DeathByLogic/shutterpod/hardware/Gerber/Shutter Pod Schematic.TXT

%
M48
M72
T01C0.0240
T02C0.0394
T03C0.0400
T04C0.0433
T05C0.0472
T06C0.0984
%
T01
X9431Y1556
X7141Y4171
X13061Y6821
X13931Y7681
X14556Y8306
X12101Y8981
X10101Y9301
X9621Y9301
X12101Y10021
X16901Y11541
X19436Y11966
X21306Y12681
X21221Y13541
X23861Y12741
X23141Y11141
X25061Y10661
X23941Y10421
X24661Y10261
X25541Y9701
X22901Y9301
X22671Y8706
X20901Y9061
X20681Y8021
X22821Y7541
X23301Y7621
X22821Y7061
X24341Y7461
X25711Y8021
X27861Y7141
X26581Y6341
X26261Y5941
X24741Y6421
X25781Y6741
X23541Y5941
X22421Y5941
X22021Y5541
X23941Y5301
X24421Y5301
X25221Y4501
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
