DeathByLogic/shutterpod/hardware/Shutter Pod Schematic.png

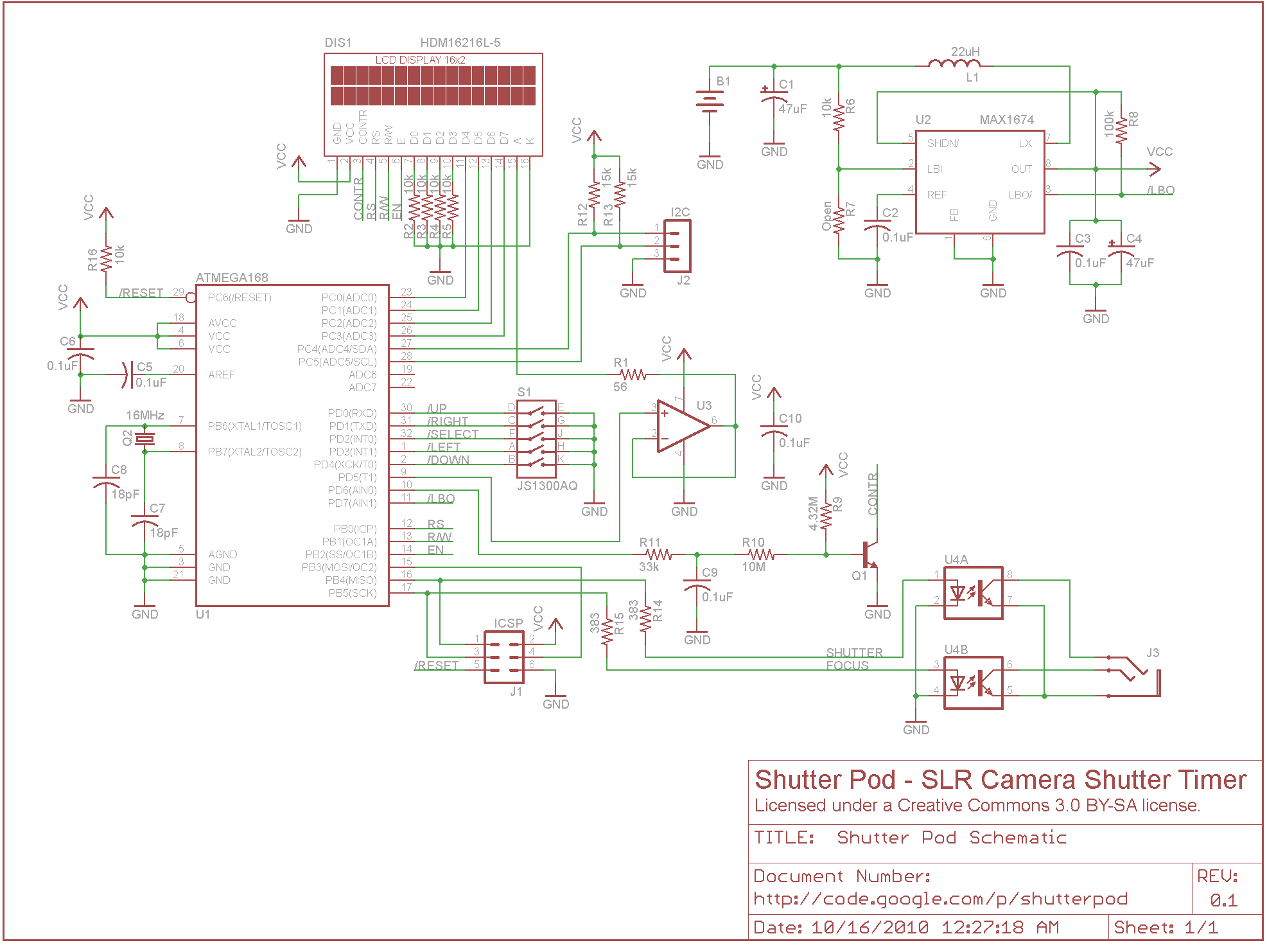
hardware/Shutter Pod Schematic.png
