DeathByLogic/shutterpod/case/Shutter Pod v1 Case.FCStd

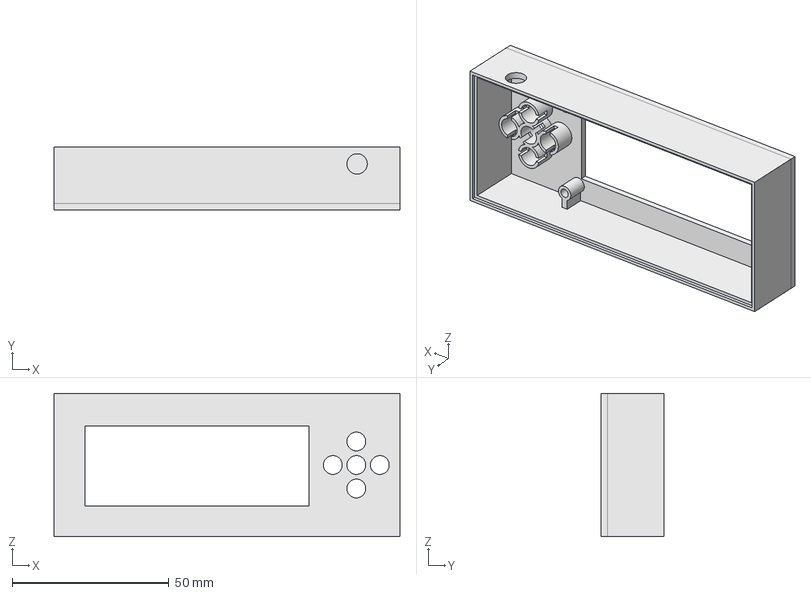
[picture p2: CAD file, 2014-07-27]
case/Shutter Pod v1 Case.FCStd
110.4 x 20.0 x 45.6 mm
