DeathByLogic/shutterpod/case/Button - Center.FCStd

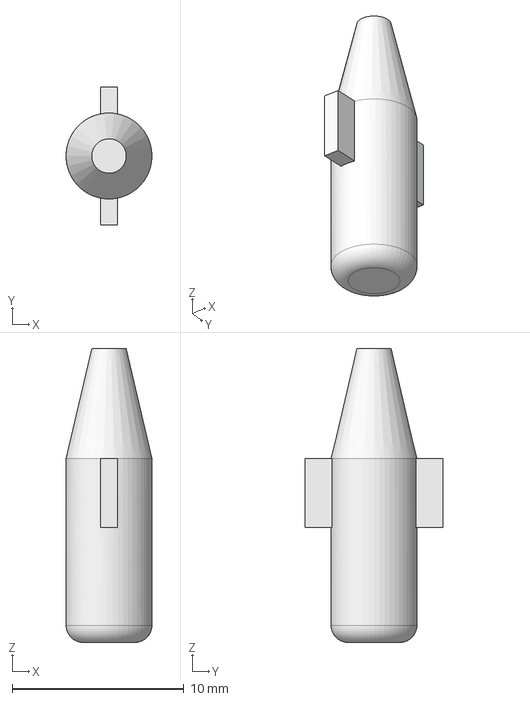
[picture p3: CAD file, 2014-07-27]
case/Button - Center.FCStd
5.00 x 8.00 x 17.1 mm
