DeathByLogic/shutterpod/case/Button - Angle.FCStd

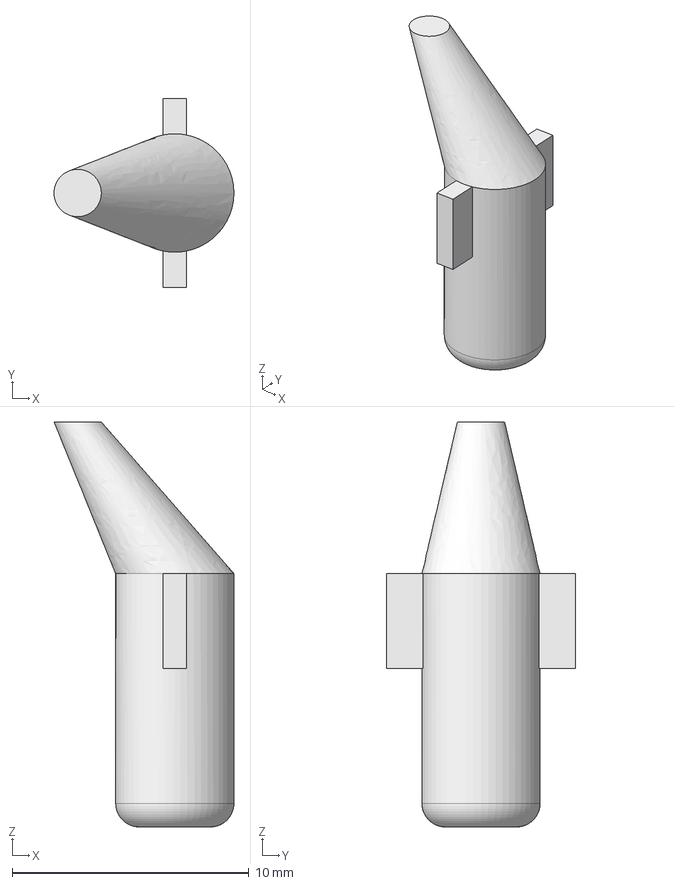
[picture p4: CAD file, 2014-07-27]
case/Button - Angle.FCStd
7.60 x 8.00 x 17.1 mm
