DeathByLogic/shutterpod/(list of files, cad)

Other CAD files:
case/Button - Angle.stl
case/Button - Center.stl
case/Shutter Pod v1 Case.stl
