DeathByLogic/shutterpod/hardware/Shutter Pod Schematic.brd

## EAGLE design hardware/Shutter Pod Schematic.brd (2014-08-19)

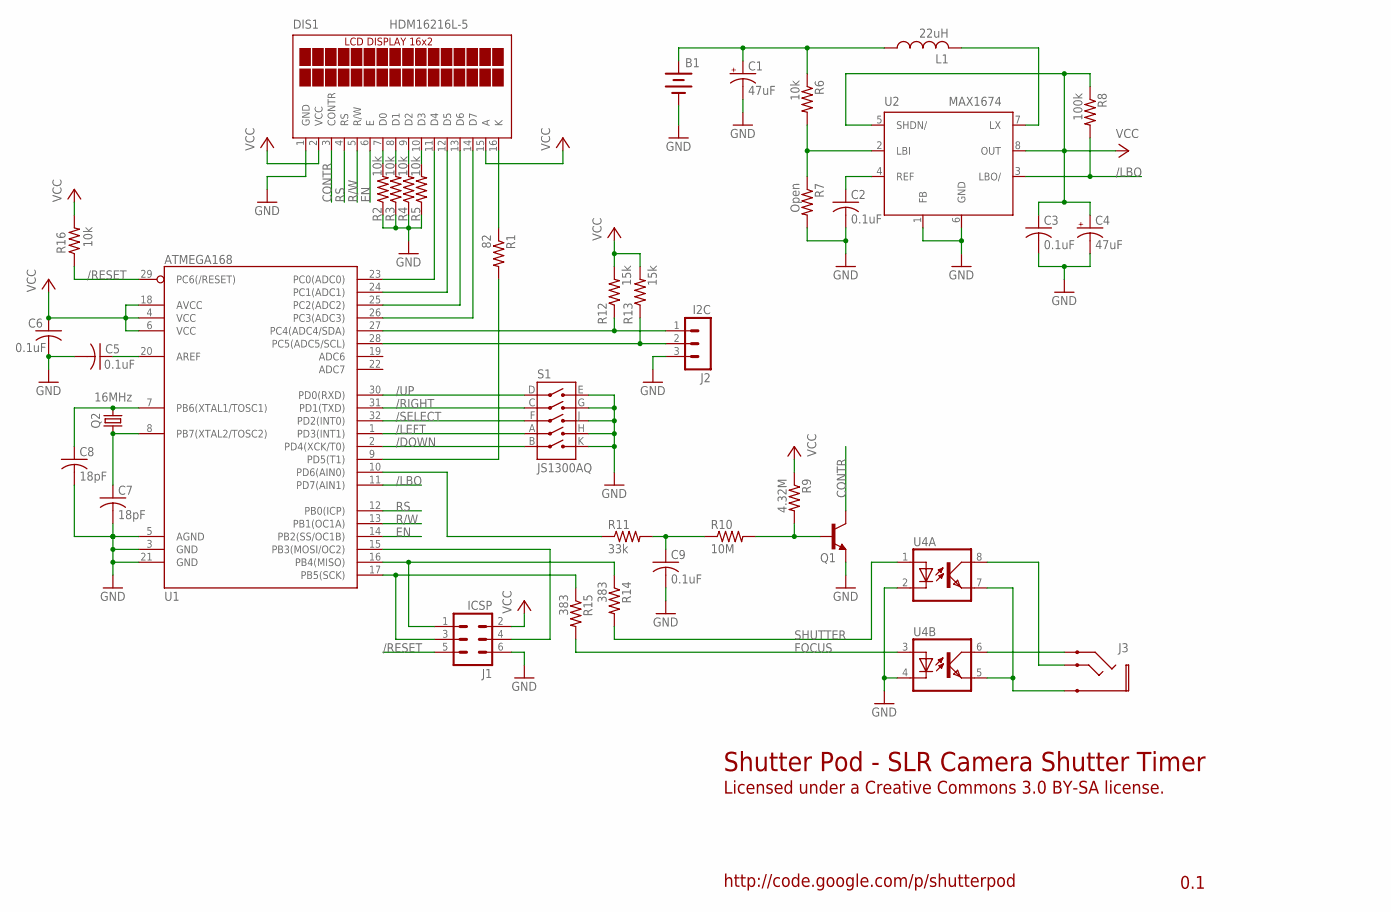
[picture p5: schematic Shutter Pod Schematic.sch]

Parts:
B1: BATTERY
C1, C4: 47uF; SMC_D
C2, C3, C5, C6, C9: 0.1uF; C0805
C7, C8: 18pF; C0805
DIS1: HDM16216L-5
J1: ICSP; MA03-2W
J2: I2C; MA03-1W
J3: 2.5MM_AUDIO; 161-2625-E
L1: 22uH; L2220P
Q1: BC817-25SMD; SOT23-BEC
Q2: 16MHz; HC49UP
R1: 82; R0805
R2, R3, R4, R5, R6, R16: 10k; R0805
R7: Open; R0805
R8: 100k; R0805
R9: 4.32M; R0805
R10: 10M; R0805
R11: 33k; R0805
R12, R13: 15k; R0805
R14, R15: 383; R0805
S1: JS1300AQ
U1: ATMEGA168; TQFP32-08
U2: MAX1674; UMAX8
U4: MOCD217M; SO08

Connections:
/DOWN: S1.B, U1.2 (PD4(XCK/T0))
/LBO: R8.2, U1.11 (PD7(AIN1)), U2.3 (LBO/)
/LEFT: S1.A, U1.1 (PD3(INT1))
/RESET: J1.5, R16.1, U1.29 (PC6(/RESET))
/RIGHT: S1.C, U1.31 (PD1(TXD))
/SELECT: S1.F, U1.32 (PD2(INT0))
/UP: S1.D, U1.30 (PD0(RXD))
CONTR: DIS1.3 (CONTR), Q1.C
EN: DIS1.6 (E), U1.14 (PB2(SS/OC1B))
FOCUS: R15.2, U4.3 (A)
GND: B1.1 (NEGATIVE), C1.-, C2.2, C3.2, C4.-, C5.2, C6.2, C7.2, C8.2, C9.2, DIS1.1 (GND), J1.6, J2.3, Q1.E, R2.1, R3.1, R4.1, R5.1, R7.2, S1.E, S1.G, S1.H, S1.J, S1.K, U1.3 (GND), U1.5 (AGND), U1.21 (GND), U2.1 (FB), U2.6 (GND), U4.2 (C), U4.4 (C)
MISO: J1.1, R14.1, U1.16 (PB4(MISO))
MOSI: J1.4, U1.15 (PB3(MOSI/OC2))
unnamed: DIS1.11 (D4), U1.23 (PC0(ADC0))
unnamed: DIS1.12 (D5), U1.24 (PC1(ADC1))
unnamed: DIS1.13 (D6), U1.25 (PC2(ADC2))
unnamed: DIS1.14 (D7), U1.26 (PC3(ADC3))
unnamed: R1.2, U1.9 (PD5(T1))
unnamed: R11.1, U1.10 (PD6(AIN0))
unnamed: Q1.B, R9.2, R10.2
unnamed: DIS1.16 (K), R1.1
unnamed: B1.2 (POSITIVE), C1.+, L1.1, R6.1
unnamed: C5.1, U1.20 (AREF)
unnamed: DIS1.7 (D0), R2.2
unnamed: DIS1.8 (D1), R3.2
unnamed: DIS1.9 (D2), R4.2
unnamed: DIS1.10 (D3), R5.2
unnamed: C2.1, U2.4 (REF)
unnamed: R6.2, R7.1, U2.2 (LBI)
unnamed: C9.1, R10.1, R11.2
unnamed: L1.2, U2.7 (LX)
unnamed: C8.1, Q2.2, U1.7 (PB6(XTAL1/TOSC1))
unnamed: C7.1, Q2.1, U1.8 (PB7(XTAL2/TOSC2))
unnamed: J3.SA (SLEEVE), U4.5 (EMIT), U4.7 (EMIT)
unnamed: J3.T (TIP), U4.8 (COL)
R/W: DIS1.5 (R/W), U1.13 (PB1(OC1A))
RS: DIS1.4 (RS), U1.12 (PB0(ICP))
SCK: J1.3, R15.1, U1.17 (PB5(SCK))
SCL: J2.2, R13.1, U1.28 (PC5(ADC5/SCL))
SDA: J2.1, R12.1, U1.27 (PC4(ADC4/SDA))
SHUTTER: R14.2, U4.1 (A)
VCC: C3.1, C4.+, C6.1, DIS1.2 (VCC), DIS1.15 (A), J1.2, R8.1, R9.1, R12.2, R13.2, R16.2, U1.4 (VCC), U1.6 (VCC), U1.18 (AVCC), U2.5 (SHDN/), U2.8 (OUT)

Notes on the sheet:
0.1
Licensed under a Creative Commons 3.0 BY-SA license.
Shutter Pod - SLR Camera Shutter Timer
http://code.google.com/p/shutterpod

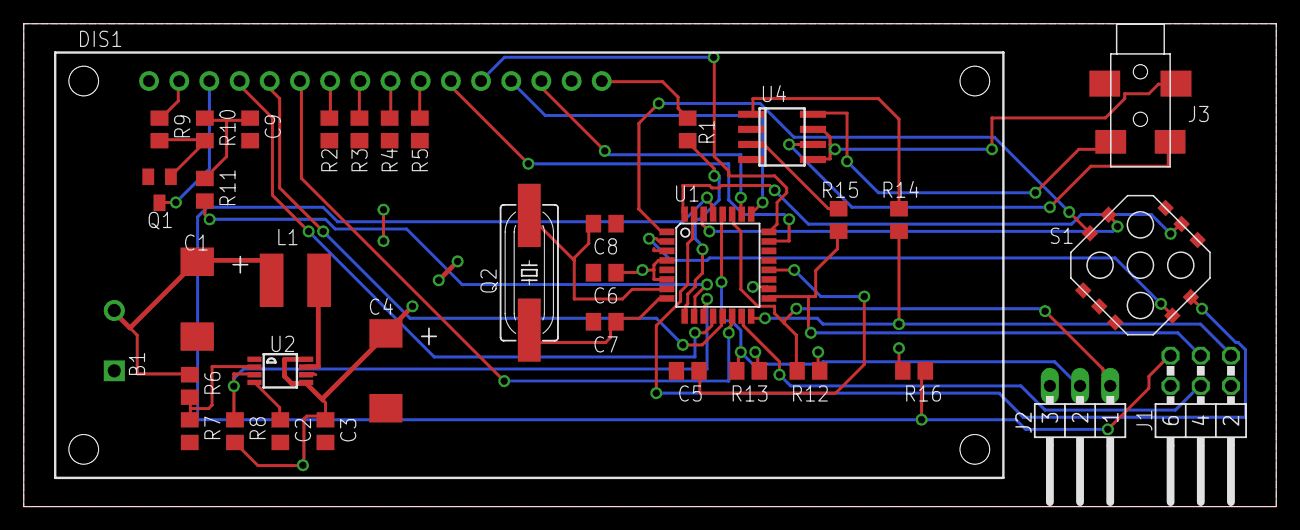
[picture p6: board Shutter Pod Schematic.brd from above]

Board: 2 copper layers, 105.4 x 40.6 mm, 37 parts (0 on the bottom side), 42 nets.
