DeathByLogic/shutterpod/firmware/src/shutter_pod.c

/*

	Project		: Shutter Pod
	File		: shutter_pod.cpp
	Description	: Main source file for project
	Date		: 6/23/2010

	Shutter Pod is an open source hardware timer for SLR cameras.
	Copyright (C) 2010 Daniel Wassenberg

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
*/

//
// Includes
//

#include <avr/interrupt.h>
#include <util/delay.h>

#include "global.h"
#include "pwm.h"
#include "camera.h"
#include "menu.h"
#include "eeprom.h"
#include "low_power.h"

//
// Function constructs
//

void config_lcd(void);
void config_io(void);
void main_menu(void);
void delay_ms(unsigned int);

//
// Global variables
//

lcd	 disp(LCD_2_LINE | LCD_5_BY_7);
fifo button_events;
system_parameters sys_param;

//
// Start of program
//

int main (void) {
	// Configure the io port directions
	config_io();

	// Read system parameters from EEPROM
	read_sys_param();

	// Configure the PWM
	pwm_init();

	// Configure the main timer
	timing_init();

	// Give time for LCD to boot
	delay_ms(300);

	// Configure the LCD
	config_lcd();

	// Print splash screen
	print_menu(MSG_SPLASH_1, MSG_SPLASH_2);

	// Wait for 2 sec
	delay_ms(2000);

	PCMSK2 = 0x1F;
	PCICR = 0x04;

	// Enable global interupts
	sei();

	// Display the menu
	update_display();

	// Goto main menu
	while (true) {
		if (enter_pwr_dwn == true) {
			enter_pwr_dwn = false;

			power_down();
		} else {
			idle();
		}
	}
}

// Wake up from sleep from button push
ISR(PCINT2_vect) {
	asm("NOP");
}

void handle_event(void) {
	// Pull next button event off stack
	uint8_t button_event = button_events.pop();

	if (button_event > 0) {
		// Clear the backlight timeout counter
		timeout_count = 0;

		// Update menu state and take actions based on button events
		menu_fsm(button_event);

		// Update the display
		update_display();

		// Update the current cursor posistion
		update_cursor();
	}
}

// Setup the i/o ports directions
void config_io(void) {
	// Enable pullups
	MCUCR &= 0x00;

	// Enable pullups on button inputs
	SETBITS(BUTTON_PORT, BUTTON_MASK);

	// Set the button pins as input
	CLEARBITS(BUTTON_DIR, BUTTON_MASK);

	// Configure PWM ports as output
	SETBITS(LCD_PWM_DIR, LCD_PWM_MASK);
	
	// Set camera triggers port direction
	SETBITS(CAMERA_DIR, CAMERA_MASK);

	// Set low battery pin as input
	CLEARBITS(LOW_BATTERY_DIR, LOW_BATTERY_MASK);
}

// Setup the LCD display
void config_lcd(void) {
	// Turn the display on
	disp.display_control(LCD_ON | LCD_UNDERLINE_OFF | LCD_CURSOR_BLINK_ON);

	// Clear the display
	disp.clear_display();

	// Goto the home location
	disp.display_home();

	disp.cursor_blink(false);
}

// Delay function
void delay_ms(unsigned int ms)
{
	while(ms){
		_delay_ms(0.96);
		ms--;
	}
}
