DeathByLogic/shutterpod/firmware/src/global.h

/*

	Project		: Shutter Pod
	File		: global.h
	Description	: Global constants, includes, ...
	Date		: 6/23/2010

	Shutter Pod is an open source hardware timer for SLR cameras.
	Copyright (C) 2010 Daniel Wassenberg

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
*/

#ifndef _GLOBAL_H
#define _GLOBAL_H

#include "lcd.h"
#include "fifo.h"

// Constants Definitions
#define true	1
#define false	0

// Macros
#define SETBITS(X, Y)				X |= Y
#define CLEARBITS(X, Y)				X &= ~Y

#define SETBIT(X, Y)				X |= (1 << Y)
#define CLEARBIT(X, Y)				X &= ~(1 << Y)

#define CONSTRAIN(VALUE, MIN, MAX)	((VALUE)<(MIN)?(MIN):((VALUE)>(MAX)?(MAX):(VALUE)))

//
// I/O Ports
//

// Pins for PWM output
#define LCD_PWM_DIR			DDRD
#define LCD_PWM_MASK		0x60

// Ports for camera triggers
#define	CAMERA_PORT			PORTB
#define	CAMERA_DIR			DDRB
#define	CAMERA_MASK			0x30

#define	SHUTTER_PIN			PORTB4
#define FOCUS_PIN			PORTB5

// Low battery input
#define LOW_BATTERY_PORT	PORTD
#define LOW_BATTERY_DIR		DDRD
#define LOW_BATTERY_MASK	0x80

#define LOW_BATTERY_PIN		PORTD7

// Button input
#define BUTTON_PORT			PORTD
#define BUTTON_PIN			PIND
#define BUTTON_DIR			DDRD
#define BUTTON_MASK			0x1F

#define BUTTON_UP			PIND0
#define BUTTON_RIGHT		PIND1
#define BUTTON_SELECT		PIND2
#define BUTTON_LEFT			PIND3
#define BUTTON_DOWN			PIND4

//
// System type defs
//

typedef struct {
	unsigned long 	focus_time;
	unsigned long 	shutter_delay;
	unsigned long 	shutter_time;

	uint8_t			contrast_level;
	unsigned long	timeout_period; 
	uint8_t			brightness_level;
	uint8_t			le_brightness_level;
	
	unsigned long	le_shutter_time;
	unsigned long	tl_period;
	unsigned long	tl_duration;
	unsigned long	td_delay_time;
} system_parameters;

// Button events
enum button_events {
	BUTTON_UP_SHORT = 1,
	BUTTON_UP_LONG,

	BUTTON_RIGHT_SHORT,
	BUTTON_RIGHT_LONG,

	BUTTON_SELECT_SHORT,
	BUTTON_SELECT_LONG,

	BUTTON_LEFT_SHORT,
	BUTTON_LEFT_LONG,

	BUTTON_DOWN_SHORT,
	BUTTON_DOWN_LONG,
};

// External Variables
extern lcd disp;
extern fifo button_events;
extern system_parameters sys_param;

#endif
