DeathByLogic/shutterpod/firmware/src/pwm.c

/*

	Project		: Shutter Pod
	File		: pwm.cpp
	Description	: PWM interrupts, functions and settings
	Date		: 7/8/2010

	Shutter Pod is an open source hardware timer for SLR cameras.
	Copyright (C) 2010 Daniel Wassenberg

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
*/

// Includes
#include <avr/interrupt.h>

#include "global.h"
#include "pwm.h"
#include "debounce.h"

// Global Variables
extern fifo button_events;

extern void handle_event(void);

//Function Constructors
void call_back(int flag, bool value);

debounce btn_db_up(&call_back, BUTTON_UP_SHORT, BUTTON_UP_LONG);
debounce btn_db_down(&call_back, BUTTON_DOWN_SHORT, BUTTON_DOWN_LONG);
debounce btn_db_left(&call_back, BUTTON_LEFT_SHORT, BUTTON_LEFT_LONG);
debounce btn_db_right(&call_back, BUTTON_RIGHT_SHORT, BUTTON_RIGHT_LONG);
debounce btn_db_select(&call_back, BUTTON_SELECT_SHORT, BUTTON_SELECT_LONG);

// Configure the PWM output for the back light, contrast and button debouncing.
void pwm_init(void) {
	// Configure Duty Cycle
	set_contrast_dc(sys_param.contrast_level);
	set_backlight_dc(sys_param.brightness_level);
	
	// Configure Time/Counter 0 for PWM
	// Compare A & B: Fast PMW mode
	// Waveform Generation:
	// - Top: 0xFF
	// - Update OCR: 0x00
	// - TOV Flag: 0xFF
	// Clock Select: CLK/8
//	TCCR0A = 0xA3;
	TCCR0B = 0x02;

	// Enable timer 0 overflow interrupt
	TIMSK0 |= 0x01;
}

void pwm_deinit(void) {
	TCCR0A = 0x00;
	TCCR0B = 0x00;

	TIMSK0 = 0x00;
}

// Set the duty cycle for the back light
void set_backlight_dc(uint8_t value) {
	if (value > 0) {
		TCCR0A = 0xA3;
	} else {
		TCCR0A = 0x83;
	}

	OCR0B = value;
}

// Set the duty cycle for the contract
void set_contrast_dc(uint8_t value) {
	OCR0A = value;
}

// General system timing interrupt
ISR(TIMER0_OVF_vect) {

	btn_db_up.update((bool)(BUTTON_PIN & (1 << BUTTON_UP)));
	btn_db_down.update((bool)(BUTTON_PIN & (1 << BUTTON_DOWN)));
	btn_db_left.update((bool)(BUTTON_PIN & (1 << BUTTON_LEFT)));
	btn_db_right.update((bool)(BUTTON_PIN & (1 << BUTTON_RIGHT)));
	btn_db_select.update((bool)(BUTTON_PIN & (1 << BUTTON_SELECT)));

	handle_event();
}

void call_back(int flag, bool value) {
	if (value == false) {
		button_events.push(flag);
	}
}
