DeathByLogic/shutterpod/(commit log)

2010-07-13 Initial commit of hardware design
    [Shutter Pod Schematic.sch]
2010-07-15 Cleaned up schematic Added second buffer back to schematic
    [Shutter Pod Schematic.sch]
2010-07-15 Added configuration for PWM output to LED backlight & contrast.
2010-07-24 added opto-couplers for shutter and focus triggers
    [Shutter Pod Schematic.sch]
2010-07-24 Wrote state machine for shutter and focus control. Configured timer 2 for 61.03 Hz clock rate
2010-08-08 Added navigation buttons Updated LCD display symbol
    [Shutter Pod Schematic.sch]
2010-08-29 Added initial board layout Switched LCD I/O pins Switched navigation button pins Changed Q3 name to Q2 Changed R13, R14 values Changed Q1 part number Changed J1, J2 to right angle headers
    [Shutter Pod Schematic.brd, Shutter Pod Schematic.sch]
2010-09-06 Adjusted pad size for L1, C1 & C4
    [Shutter Pod Schematic.sch]
2010-09-14 Tweaked schematic layout Switched to single comparator package for U3 Added filter capacitor for U3
    [Shutter Pod Schematic.sch]
2010-09-14 Initial commit Gerber files Updated PCB layout
    [Shutter Pod Schematic.brd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]
2010-09-14 Fixed I2C labeling mistake on silkscreen
    [Shutter Pod Schematic.brd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]
2014-01-13 Added full menu structure to menu.c; Updated camera state machine; Other misc updates.
2014-01-14 Moved camera timer to Timer/Counter1 with frequency of 100 Hz
2014-04-19 Corrected issue with up button not registering.
    [global.h]
2014-04-19 Corrected set_backlight_dc and set_contrast_dc function definitions.
    [pwm.h]
2014-05-17 Data bus not defaults to output to reduce power.
2014-05-17 Change default times to values that worked with camera.
2014-05-17 Worked on lowering power usage. - Disabling outputs when not in use - "Shutdown" mode - LCD back-light timeout Moved LCD text into menu.c Cleaned up code for back-light and contrast settings.
2014-07-27 Initial commit of version 1 case.
    [Button - Angle.FCStd, Button - Angle.stl, Button - Center.FCStd, Button - Center.stl, Shutter Pod v1 Case.FCStd, Shutter Pod v1 Case.stl]
2014-08-18 Spelling corrections; Change contrast range to full available range.
    [pwm.c]
2014-08-19 Added eagle cad library
2014-08-19 Corrected schematic symbol and layout for J3.
    [Shutter Pod Schematic.brd, Shutter Pod Schematic.sch]
